rodrigorcviana/supply/supply-BOM.xlsx

BOM - supply
Identificador | Quantidade | Valor | Descrição | Encapsulamento | Part number | Fabricante | Preço Unitário (US$)
12V, 6V, 5V, 3.3V, 1.8V | 5 | - | led verde difuso 2.2V smd | 0805 | LG R971-KN-1 | OSRAM opto Semiconductors inc. | 0.26
C1, C6 | 2 | 10uF | Capacitor ceramico 10% X7R 50V | 1206 | CL31B106KBHNNNE | Samsumg Electro-Mechanics America, inc. | 0.33
C2, C7 | 2 | 2.2uF | Capacitor ceramico 10% X7R 16V | 0805 | GRM21BR71C225KA12L | Murata Eletronics | 0.2
C3, C8 | 2 | 100nF | Capacitor ceramico 10% X7R 16V | 0805 | GRM219R71C104KA01D | Murata Eletronics | 0.14
C4 | 1 | 18pF | Capacitor ceramico 10% C0G 50V | 0805 | C0805C180K5GACTU | KEMET | 0.1
C5 | 1 | 33uF | Capacitor ceramico 20% X5R 16V | 1206 | C3216X5R1C336M160AB | TDK Corporation | 1.06
C9 | 1 | 33pF | Capacitor ceramico 10% C0G 50V | 0805 | C0805C330K5GACTU | KEMET | 0.1
C10 | 1 | 47uF | Capacitor ceramico 20% X5R 16V | 1206 | C3216X5R1C476M160AB | TDK Corporation | 1.06
C11, C15 | 2 | 10uF | Capacitor ceramico 10% X7R 25V | 1206 | CL31B106KAHNNNE | Samsumg Electro-Mechanics America, inc. | 0.27
C12 | 1 | 1nF | Capacitor ceramico 10% X7R 16V | 0805 | C0805C102K4RACTU | KEMET | 0.1
C13 | 1 | 1uF | Capacitor ceramico 10% X7R 16V | 0805 | CC0805KKX7R7BB105 | Yageo | 0.11
C14 | 1 | 82pF | Capacitor ceramico 5% C0G 50V | 0805 | CL21C820JBANNNC | Samsumg Electro-Mechanics America, inc. | 0.1
C16 | 1 | 4.7uF | Capacitor ceramico 10% X7R 10V | 0805 | LMK212B7475KG-T | Taiyo Yuden | 0.25
C17, C18 | 2 | 1uF | Capacitor ceramico 10% X7R 50V | 0805 | GRM21BR71H105KA12L | Murata Eletronics | 0.36
C19, C20, C28, C29 | 4 | 1uF | Capacitor ceramico 10% X5R 25V | 0603 | GRM188R61E105KA12D | Murata Eletronics | 0.1
C21 ,C22, C23, C24, C25 | 5 | 10uF | Capacitor ceramico 10% X5R 25V | 1206 | GRM31CR61E106KA12L | Murata Eletronics | 0.29
C26, C27 | 2 | 22uF | Capacitor ceramico 10% X5R 25V | 1206 | CL31A226KAHNNNE | Samsumg Electro-Mechanics America, inc. | 0.51
C30 | 1 | 10pF | Capacitor ceramico 5% C0G 50V | 0603 | CC0603JRNPO9BN100 | Yageo | 0.1
C31 | 1 | 4.7nF | Capacitor ceramico 10% X7R 50V | 0603 | CC0603KRX7R9BB472 | Yageo | 0.1
C32 | 1 | 470uF | Capacitor aluminio 20% 16V | Radial | EEE-FP1C471AP | Panasonic Eletronic Components | 0.88
C33 | 1 | 330nF | Capacitor ceramico 10% X7R 16V | 0603 | GRM188R71C334KA01D | Murata Eletronics | 0.15
C34 | 1 | 100nF | Capacitor ceramico 10% X7R 16V | 0603 | CC0603KRX7R7BB104 | Yageo | 0.1
CF1 | 1 | 1uF | Capacitor feedthrough 20% 16V | 0805 | NFM21PC105B1C3D | Murata Eletronics | 0.24
D1 | 1 | 6.8V | Diodo zener 5W 5% | SMB | SMBJ5342B-TP | Micro Comercial Co | 0.65
D2 | 1 | 30V/2A | Diodo, Ultra Low Forward Voltage Drop | SOD123 | SBR2U30P1-7 | Diodes Incorporated | 0.5
D3, D4 | 2 | 40V/1A | Diodo shottky | SOD323 | PD3S140-7 | Diodes Incorporated | 0.45
DZ1 | 1 | 5.1V | Diodo zener 5.1V 500MW | SOD123 | MMSZ5V1T1G | ON Semiconductor | 0.23
F1 | 1 | 6V/350A | PTC resetavel 6V .350A | 1210 | 1210L035YR | Littefuse inc. | 0.57
FB1 | 1 | 1.5kOhm/100Mhz | Ferrite | 0603 | MMZ1608Y152BTA00 | TDK Corporation | 0.1
IC1 | 1 | - | Regulador Boost ajustavel 2A | 8-MSOP | ADP1613ARMZ-R7 | Analog Devices inc | 2.19
IC2, IC3 | 2 | - | step-down regulator ic | SO-8 | LMR23625CQDDARQ1 | Texas Instruments | 3.91
IC4 | 1 | - | regulador linear ajustavel de resposta rapida e soft start | TO263-7 | LP38851SX-ADJ/NOPB | Texas Instruments | 1.94
IC5 | 1 | - | Regulador linear fixo 6V 1.5A | D2PAK | L7806CD2T-TR | STMicroeletronics | 0.72
IC6 | 1 | - | Sensor de corrente hall 100ADC | 5-CB | ACS758LCB-100B-PFF-T | Allegro MicroSystems | 7.98
IC7 | 1 | - | AMPOP de precisão 20MHz Single supply | SO-8 | AD8616ARZ-REEL7 | Analog Devices inc | 3.71
J1, J3 | 3 | 4pos | Conector kk .100" | - | 22232041 | Molex, LLC | 0.27
J2 | 1 | 4pos | conector kk 90º 100" | - | 22122044 | Molex, LLC | 0.91
J4, J5 | 2 | 3pos | Conector kk .100" | - | 22232031 | Molex, LLC | 0.23
J6 |  | 10pos | conector kk 90º 100" | - | 22122104 | Molex, LLC | 1.82
L1, L2 | 2 | 2.2 uH | Indutor blindado SM | - | NR3010T2R2M | Taiyo Yuden | 0.41
L3, L4 | 2 | 10uH | Indutor blindado SM, 20% 1.76A | - | MSD7342-103MLB | Coilcraft | 2.24
L5 | 1 | 0.68uH | Indutor blindado SM 1.7A | - | VLS2012ET-R68N | TDK Corporation | 0.39 | Indutor ideal: | PFL1610-681MEU
P$1 | 2 | - | Conector de parafuso | - | 8191 | Keystone Eletronics | 0.45
Q1 | 1 | 30V/3.3A | Mosfet N-CH 30V 3.3A | SOT23 | SI2304DDS-T1-GE3 | Vishay Siliconix | 0.46
R1 | 1 | 88.7k | Resistor 1% 1/10W | 0603 | RC0603FR-0788K7L | Yageo | 0.1
R2, R4 | 2 | 22.1k | Resistor 1% 1/10W | 0603 | RC0603FR-0722K1L | Yageo | 0.1
R3 | 1 | 51k | Resistor 1% 1/10W | 0603 | RC0603FR-0751KL | Yageo | 0.1
R5 | 1 | 2.94k | Resistor 1% 1/10W | 0603 | RC0603FR-072K94L | Yageo | 0.1
R6 | 1 | 1.13k | Resistor 1% 1/10W | 0603 | RC0603FR-071K13L | Yageo | 0.1
R7 | 1 | 560R | Resistor 5% 1/8W | 0805 | RC0805JR-07560RL | Yageo | 0.1
R8, R22 | 2 | 330R | Resistor 5% 1/8W | 0805 | RC0805JR-07330RL | Yageo | 0.1
R9 | 1 | 220R | Resistor 5% 1/8W | 0805 | RC0805FR-07220RL | Yageo | 0.1
R10 | 1 | 1.4R | Resistor 1% 1/10W | 0603 | AC0603FR-071R4L | Yageo | 0.1
R11 | 1 | 52.3R | Resistor 1% 1/10W | 0603 | RC0603FR-0752R3L | Yageo | 0.1
R12, R13 | 2 | 0R | Resistor 1% 1/10W | 0603 | ERJ-3GEY0R00V | Panasonic Eletronic Components | 0.1
R15 | 1 | 523k | Resistor 1% 1/10W | 0603 | RC0603FR-07523KL | Yageo | 0.1
R16 | 1 | 4.22k | Resistor 1% 1/10W | 0603 | RC0603FR-074K22L | Yageo | 0.1
R17 | 1 | 47.5k | Resistor 1% 1/10W | 0603 | RC0603FR-0747K5L | Yageo | 0.1
R18, R21 | 2 | 100R | Resistor 1% 1/8W | 0805 | RC0805FR-07100RL | Yageo | 0.1
R19 | 1 | 200k | Resistor 1% 1/8W | 0805 | RC0805FR-07200KL | Yageo | 0.1
R20 | 1 | 33k | Resistor 1% 1/8W | 0805 | RC0805FR-0733KL | Yageo | 0.1
