rodrigorcviana/supply/supply.brd

## EAGLE design supply.brd (2021-04-13)

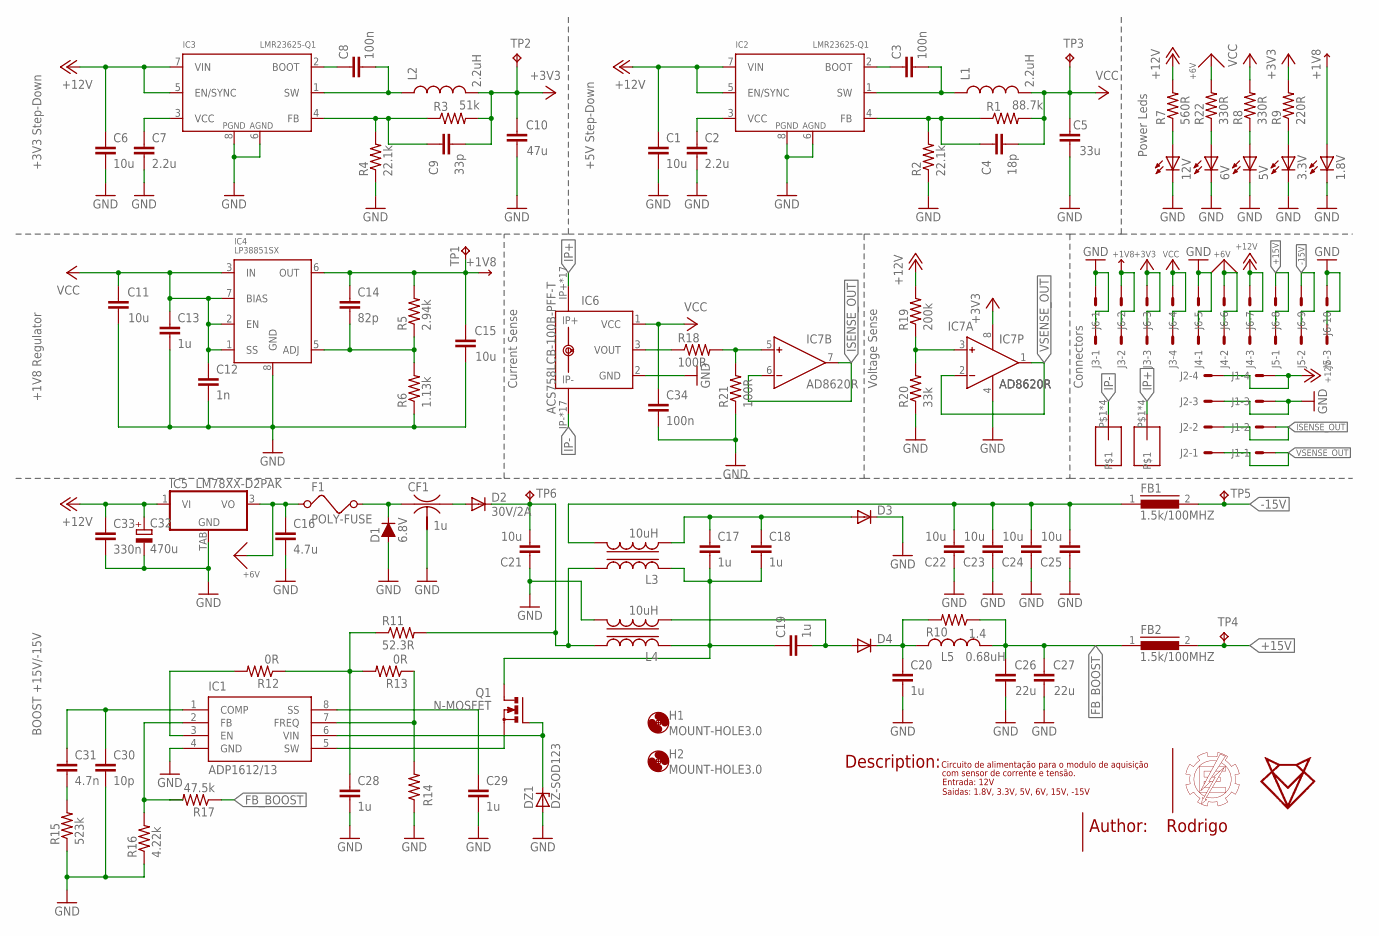
[picture p1: schematic supply.sch]

Parts:
1.8V, 3.3V, 5V, 6V, 12V: LEDCHIP-LED0805; CHIP-LED0805
C1, C6, C11, C15, C21, C22, C23, C24, C25: 10u; C1206
C2, C7: 2.2u; C0805
C3, C8: 100n; C0805
C4: 18p; C0805
C5: 33u; C1206
C9: 33p; C0805
C10: 47u; C1206
C12: 1n; C0805
C13, C17, C18: 1u; C0805
C14: 82p; C0805
C16: 4.7u; C0805
C19, C20, C28, C29: 1u; C0603
C26, C27: 22u; C1206
C30: 10p; C0603
C31: 4.7n; C0603
C32: 470u; 150CLZ-0810
C33: 330n; C0603
C34: 100n; C0603
CF1: 1u; NFM21C
D1: 6.8V; SMB
D2: 30V/2A; SOD123
D3, D4: DIODE-SOD323-W; SOD323-W
DZ1: DZ-SOD123; SOD123
F1: POLY-FUSE; 1210
FB1, FB2: 1.5k/100MHZ; 0603
H1, H2: MOUNT-HOLE3.0; 3,0
IC1: ADP1612/13; 8-MSOP
IC2, IC3: LMR23625-Q1; SO08
IC4: LP38851SX; TO263-7
IC5: LM78XX-D2PAK; TO263-3
IC6: ACS758LCB-100B-PFF-T; CB-PFF
IC7: AD8620R; SO8
J1: 22-05-7048-04; 7395-04
J2, J3: 22-27-2041-04; 6410-04
J4, J5: 22-27-2031-03; 6410-03
J6: 22-05-7108-10; 7395-10
L1, L2: 2.2uH; L-NR3010
L3, L4: 10uH; MSD7342-SMD
L5: 0.68uH; L2012C
Q1: N-MOSFET; SOT23
R1: 88.7k; R0603
R2, R4: 22.1k; R0603
R3: 51k; R0603
R5: 2.94k; R0603
R6: 1.13k; R0603
R7: 560R; R0603
R8, R22: 330R; R0603
R9: 220R; R0603
R10: 1.4; R0603
R11: 52.3R; R0603
R12, R13: 0R; R0603
R14: R-US_R0603; R0603
R15: 523k; R0603
R16: 4.22k; R0603
R17: 47.5k; R0603
R18, R21: 100R; R0805
R19: 200k; R0805
R20: 33k; R0805
TP1, TP2, TP3, TP4, TP5, TP6: TPPAD1-13; P1-13
U$3, U$4: SCREWCONECTOR

Connections:
+1V8: 1.8V.A, C14.1, C15.2, IC4.6 (OUT), J3.2, J6.2, R5.2, TP1.TP
+3V3: C9.2, C10.2, IC7.8 (V+), J3.3, J6.3, L2.P$2 (2), R3.2, R9.2, TP2.TP
+6V: C16.1, F1.1, IC5.3 (VO), J4.2, J6.6, R22.2
+12V: C1.1, C6.1, C32.+, C33.1, IC2.5 (EN/SYNC), IC2.7 (VIN), IC3.5 (EN/SYNC), IC3.7 (VIN), IC5.1 (VI), J1.4, J2.4, J4.3, J6.7, R7.2, R19.2
+15V: FB2.2, J5.1, J6.8, TP4.TP
-15V: FB1.2, J5.2, J6.9, TP5.TP
FB_BOOST: C26.2, C27.2, FB2.1, L5.2, R10.1, R17.1
GND: 1.8V.C, 3.3V.C, 5V.C, 6V.C, 12V.C, C1.2, C2.2, C5.1, C6.2, C7.2, C10.1, C11.1, C12.2, C13.2, C15.1, C16.2, C20.2, C21.1, C22.1, C23.1, C24.1, C25.1, C26.1, C27.1, C28.2, C29.2, C30.2, C32.-, C33.2, C34.2, CF1.2@1 (2), D1.2 (A), D3.C, DZ1.A, IC1.4 (GND), IC2.6 (AGND), IC2.8 (PGND), IC3.6 (AGND), IC3.8 (PGND), IC4.8 (GND), IC5.TAB (GND), IC6.2 (GND), IC7.4 (V-), J1.3, J2.3, J3.1, J4.1, J5.3, J6.1, J6.5, J6.10, L4.P$2 (2), R2.1, R4.1, R6.1, R14.1, R15.1, R16.1, R20.1, R21.1
IP+: IC6.IP+, IC6.IP+@2 (IP+), IC6.IP+@3 (IP+), IC6.IP+@4 (IP+), IC6.IP+@5 (IP+), IC6.IP+@6 (IP+), IC6.IP+@7 (IP+), IC6.IP+@8 (IP+), IC6.IP+@9 (IP+), IC6.IP+@10 (IP+), IC6.IP+@11 (IP+), IC6.IP+@12 (IP+), IC6.IP+@13 (IP+), IC6.IP+@14 (IP+), IC6.IP+@15 (IP+), IC6.IP+@16 (IP+), IC6.IP+@17 (IP+), U$4.P$1, U$4.P$2, U$4.P$3, U$4.P$4
IP-: IC6.IP-, IC6.IP-@2 (IP-), IC6.IP-@3 (IP-), IC6.IP-@4 (IP-), IC6.IP-@5 (IP-), IC6.IP-@6 (IP-), IC6.IP-@7 (IP-), IC6.IP-@8 (IP-), IC6.IP-@9 (IP-), IC6.IP-@10 (IP-), IC6.IP-@11 (IP-), IC6.IP-@12 (IP-), IC6.IP-@13 (IP-), IC6.IP-@14 (IP-), IC6.IP-@15 (IP-), IC6.IP-@16 (IP-), IC6.IP-@17 (IP-), U$3.P$1, U$3.P$2, U$3.P$3, U$3.P$4
ISENSE_OUT: IC7.6 (IN-), IC7.7 (OUT), J1.2, J2.2
unnamed: C3.1, IC2.2 (BOOT)
unnamed: C7.1, IC3.3 (VCC)
unnamed: C2.1, IC2.3 (VCC)
unnamed: C3.2, IC2.1 (SW), L1.P$1 (1)
unnamed: C4.1, IC2.4 (FB), R1.1, R2.2
unnamed: C8.1, IC3.2 (BOOT)
unnamed: C8.2, IC3.1 (SW), L2.P$1 (1)
unnamed: C9.1, IC3.4 (FB), R3.1, R4.2
unnamed: CF1.1, D1.1 (C), F1.2
unnamed: CF1.3, D2.A
unnamed: IC6.3 (VOUT), R18.1
unnamed: C14.2, IC4.5 (ADJ), R5.1, R6.2
unnamed: C31.2, R15.2
unnamed: C17.1, C18.1, D3.A, L3.P$4 (4)
unnamed: C19.2, D4.A, L4.P$4 (4)
unnamed: 12V.A, R7.1
unnamed: C20.1, D4.C, L5.1, R10.2
unnamed: 3.3V.A, R9.1
unnamed: 5V.A, R8.1
unnamed: C22.2, C23.2, C24.2, C25.2, FB1.1, L3.P$2 (2)
unnamed: IC1.5 (SW), Q1.2 (S)
unnamed: C28.1, R11.1, R12.1, R13.2
unnamed: IC1.3 (EN), R12.2
unnamed: IC1.2 (FB), R16.2, R17.2
unnamed: C29.1, IC1.8 (SS)
unnamed: IC1.7 (FREQ), R13.1, R14.2
unnamed: C30.1, C31.1, IC1.1 (COMP)
unnamed: 6V.A, R22.1
unnamed: DZ1.C, IC1.6 (VIN), Q1.1 (G)
unnamed: C21.2, D2.C, L3.P$1 (1), L4.P$1 (1), R11.2, TP6.TP
unnamed: C17.2, C18.2, C19.1, L3.P$3 (3), L4.P$3 (3), Q1.3 (D)
unnamed: IC7.3 (IN+), R19.1, R20.2
unnamed: IC7.5 (IN+), R18.2, R21.2
VCC: C4.2, C5.2, C11.2, C12.1, C13.1, C34.1, IC4.1 (SS), IC4.2 (EN), IC4.3 (IN), IC4.7 (BIAS), IC6.1 (VCC), J3.4, J6.4, L1.P$2 (2), R1.2, R8.2, TP3.TP
VSENSE_OUT: IC7.1 (OUT), IC7.2 (IN-), J1.1, J2.1

Notes on the sheet:
BOOST +15V/-15V
+1V8 Regulator
+3V3 Step-Down
+5V Step-Down
Power Leds
Current Sense
Voltage Sense
Connectors
Circuito de alimentação para o modulo de aquisição
Entrada: 12V Saidas: 1.8V, 3.3V, 5V, 6V, 15V, -15V
Description:
Author:
Rodrigo
com sensor de corrente e tensão.

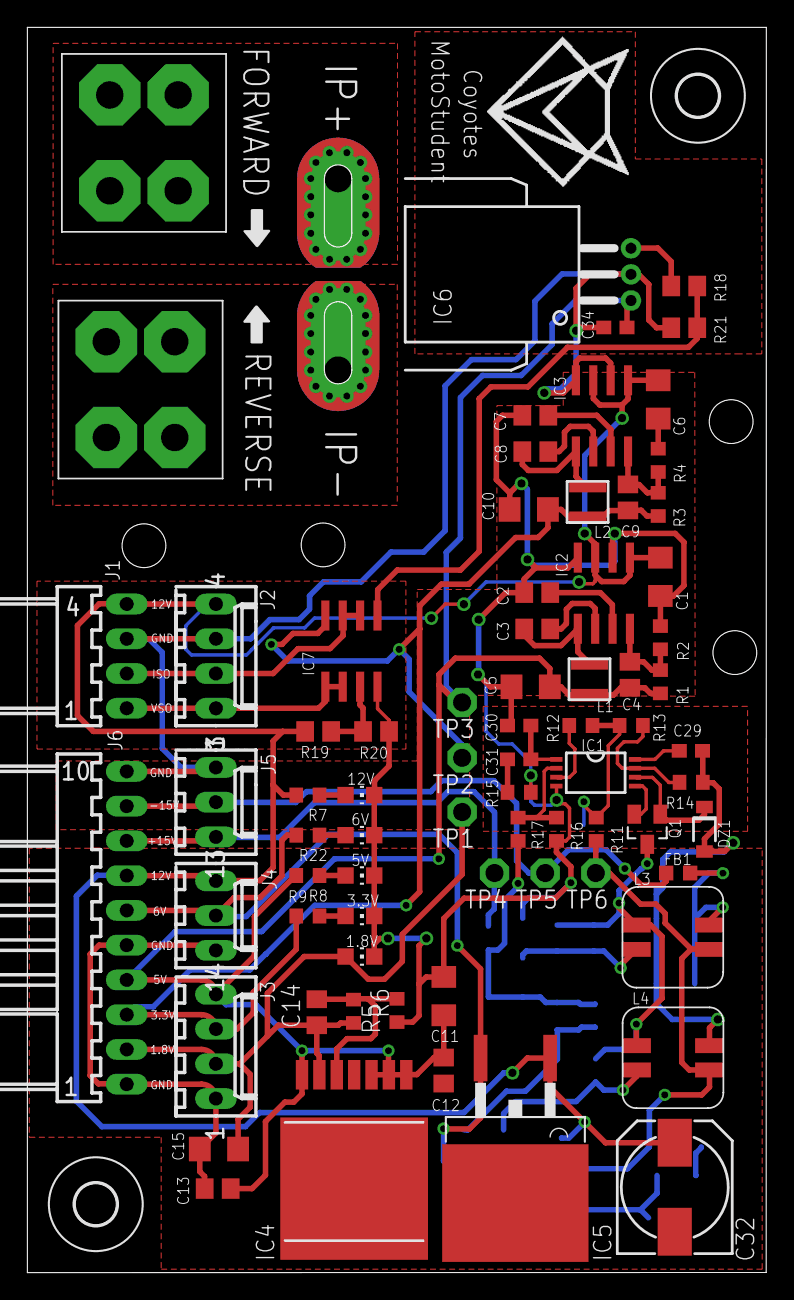
[picture p2: board supply.brd from above]

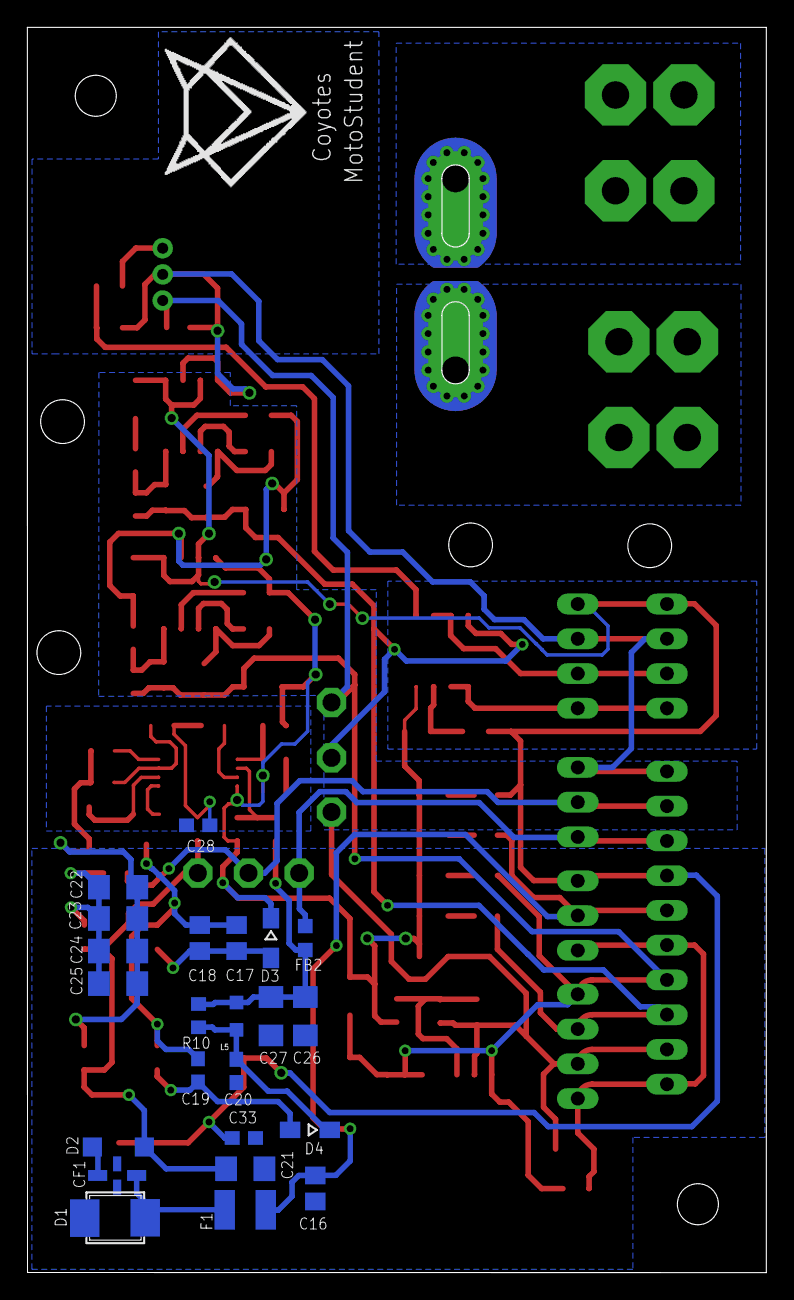
[picture p3: board supply.brd from below]

Board: 2 copper layers, 54.0 x 91.0 mm, 103 parts (24 on the bottom side), 46 nets.

Other parts of the board:
U$11, U$12: LOGO_COYOTES
U$13, U$14: SETA_DIREITA
